serolugo/fpga-universal-expansion-board/images/picture01.jpeg

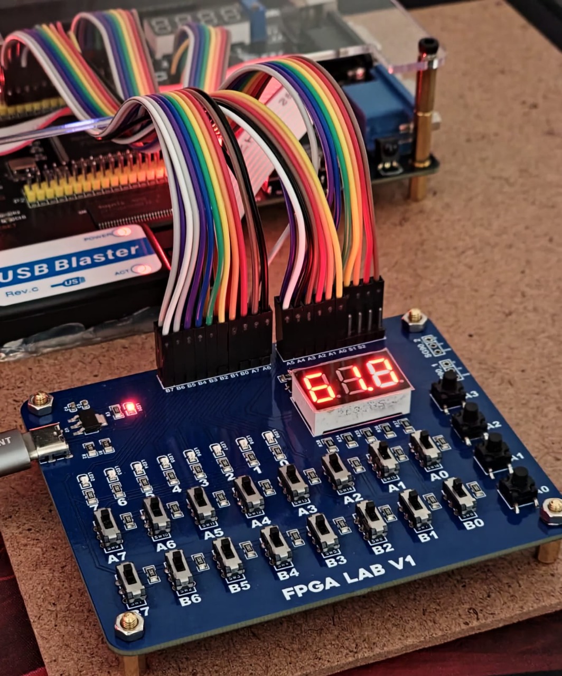
images/picture01.jpeg
