serolugo/fpga-universal-expansion-board/Rev.2/images/2d_pcb_front.png

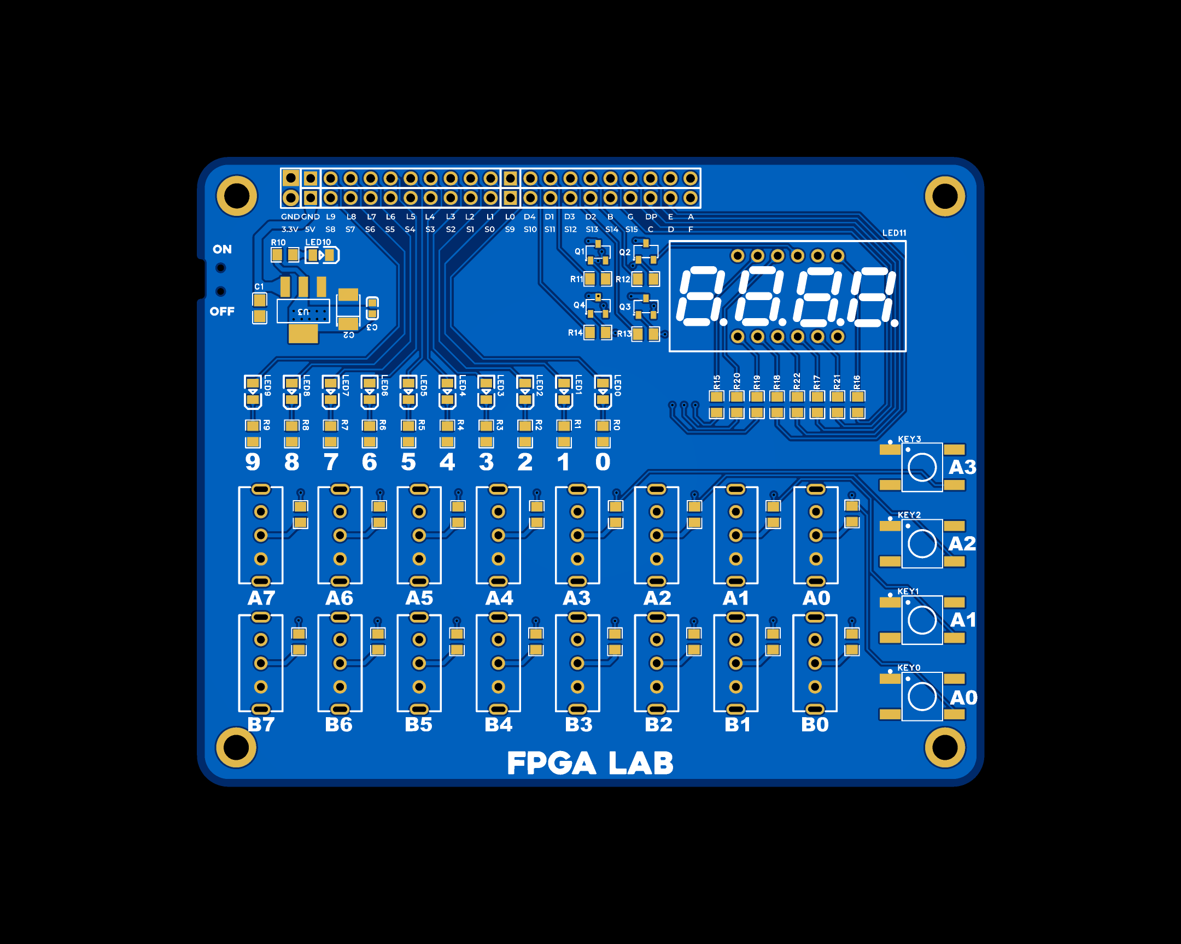
Rev.2/images/2d_pcb_front.png
