serolugo/fpga-universal-expansion-board/Rev.2/images/3d_pcb_back.png

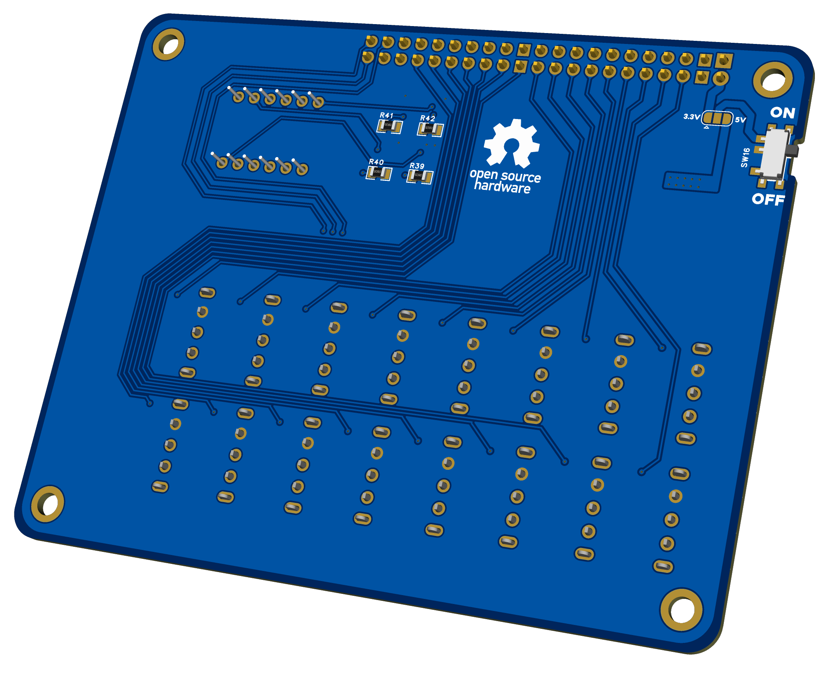
Rev.2/images/3d_pcb_back.png
