serolugo/fpga-universal-expansion-board/Rev.2/Schematic/SCH_Schematic1_2026-01-11.jpg

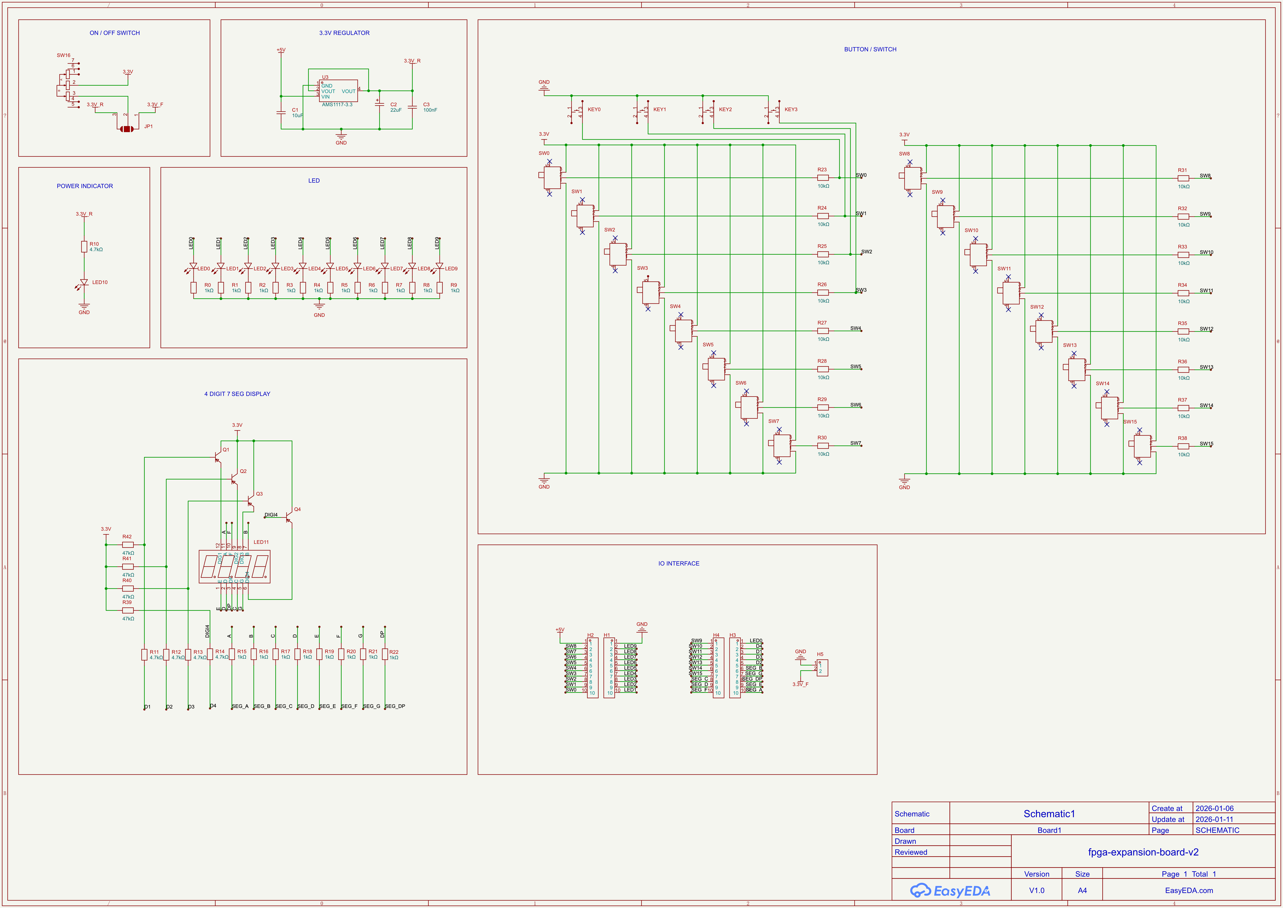
Rev.2/Schematic/SCH_Schematic1_2026-01-11.jpg
