serolugo/fpga-universal-expansion-board/Rev.2/bom/BOM_Board1_PCB1_2026-01-11.csv

No. | Quantity | Comment | Designator | Footprint | Value | Manufacturer Part | Manufacturer | Supplier Part | Supplier
1 | 1 | 10uF | C1 | C0805 | 10uF | GRM21BR61H106KE43L | muRata(村田) | C440198 | LCSC
2 | 1 | 22uF | C2 | CASE-B_3528 | 22uF | TAJB226K016RNJ | Kyocera AVX | C8020 | LCSC
3 | 1 | 100nF | C3 | C0603 | 100nF | CC0603KRX7R9BB104 | YAGEO(国巨) | C14663 | LCSC
4 | 4 | 5AML4-11560-110-W0 | H1,H2,H3,H4 | HDR-TH_10P-P2.54-V-M-1 |  | 5AML4-11560-110-W0 | SAMZO(三佐) | C41374240 | LCSC
5 | 1 | FG-PZ2.54-01-02P | H5 | HDR-TH_2P-P2.54-V-M |  | FG-PZ2.54-01-02P | FG(富港) | C42391436 | LCSC
6 | 1 | Jumper:SolderJumper-3_P1.3mm_Open_RoundedPad1.0x1.5mm | JP1 | Jumper:SolderJumper-3_P1.3mm_Open_RoundedPad1.0x1.5mm
7 | 4 | KH-6X6X6H-SMT-FS-D | KEY0,KEY1,KEY2,KEY3 | SW-SMD_4P-L6.0-W6.0-P4.50-LS9.5 |  | KH-6X6X6H-SMT-FS-D | kinghelm(金航标) | C18186510 | LCSC
8 | 11 | NCD0805R1 | LED0,LED1,LED2,LED3,LED4,LED5,LED6,LED7,LED8,LED9,LED10 | LED0805-R-RD |  | NCD0805R1 | 国星光电 | C84256 | LCSC
9 | 1 | SR410361N | LED11 | LED-SEG-TH_12P-L30.0-W14.0-P2.54-S10.26-BL |  | SR410361N | ARKLED(方舟) | C132660 | LCSC
10 | 4 | SS8550 | Q1,Q2,Q3,Q4 | SOT-23-3_L2.9-W1.4-P1.90-LS2.6-BR |  | SS8550 | TWGMC(迪嘉) | C727138 | LCSC
11 | 18 | 1kΩ | R0,R1,R2,R3,R4,R5,R6,R7,R8,R9,R15,R16,R17,R18,R19,R20,R21,R22 | R0805 | 1kΩ | 0805W8F1001T5E | UNI-ROYAL(厚声) | C17513 | LCSC
12 | 5 | 4.7kΩ | R10,R11,R12,R13,R14 | R0805 | 4.7kΩ | 0805W8F4701T5E | UNI-ROYAL(厚声) | C17673 | LCSC
13 | 16 | 10kΩ | R23,R24,R25,R26,R27,R28,R29,R30,R31,R32,R33,R34,R35,R36,R37,R38 | R0805 | 10kΩ | 0805W8F1002T5E | UNI-ROYAL(厚声) | C17414 | LCSC
14 | 4 | 47kΩ | R39,R40,R41,R42 | R0805 | 47kΩ | 0805W8F4701T5E | UNI-ROYAL(厚声) |  | LCSC
15 | 16 | SS12F44G4 | SW0,SW1,SW2,SW3,SW4,SW5,SW6,SW7,SW8,SW9,SW10,SW11,SW12,SW13,SW14,SW15 | SW-TH_SHOU-HAN_SS12F44G4 |  | SS12F44G4 | SHOU HAN(首韩) | C2887261 | LCSC
16 | 1 | MK-12C02-G015 | SW16 | SW-SMD_G-SWITCH_MK-12C02-G015 |  | MK-12C02-G015 | G-Switch(品赞) | C2911519 | LCSC
17 | 1 | AMS1117-3.3 | U3 | SOT-223-3_L6.5-W3.4-P2.30-LS7.0-BR |  | AMS1117-3.3 | AMS | C6186 | LCSC
