serolugo/fpga-universal-expansion-board/Rev.2/Schematic/SCH_Schematic1_2026-01-11.pdf

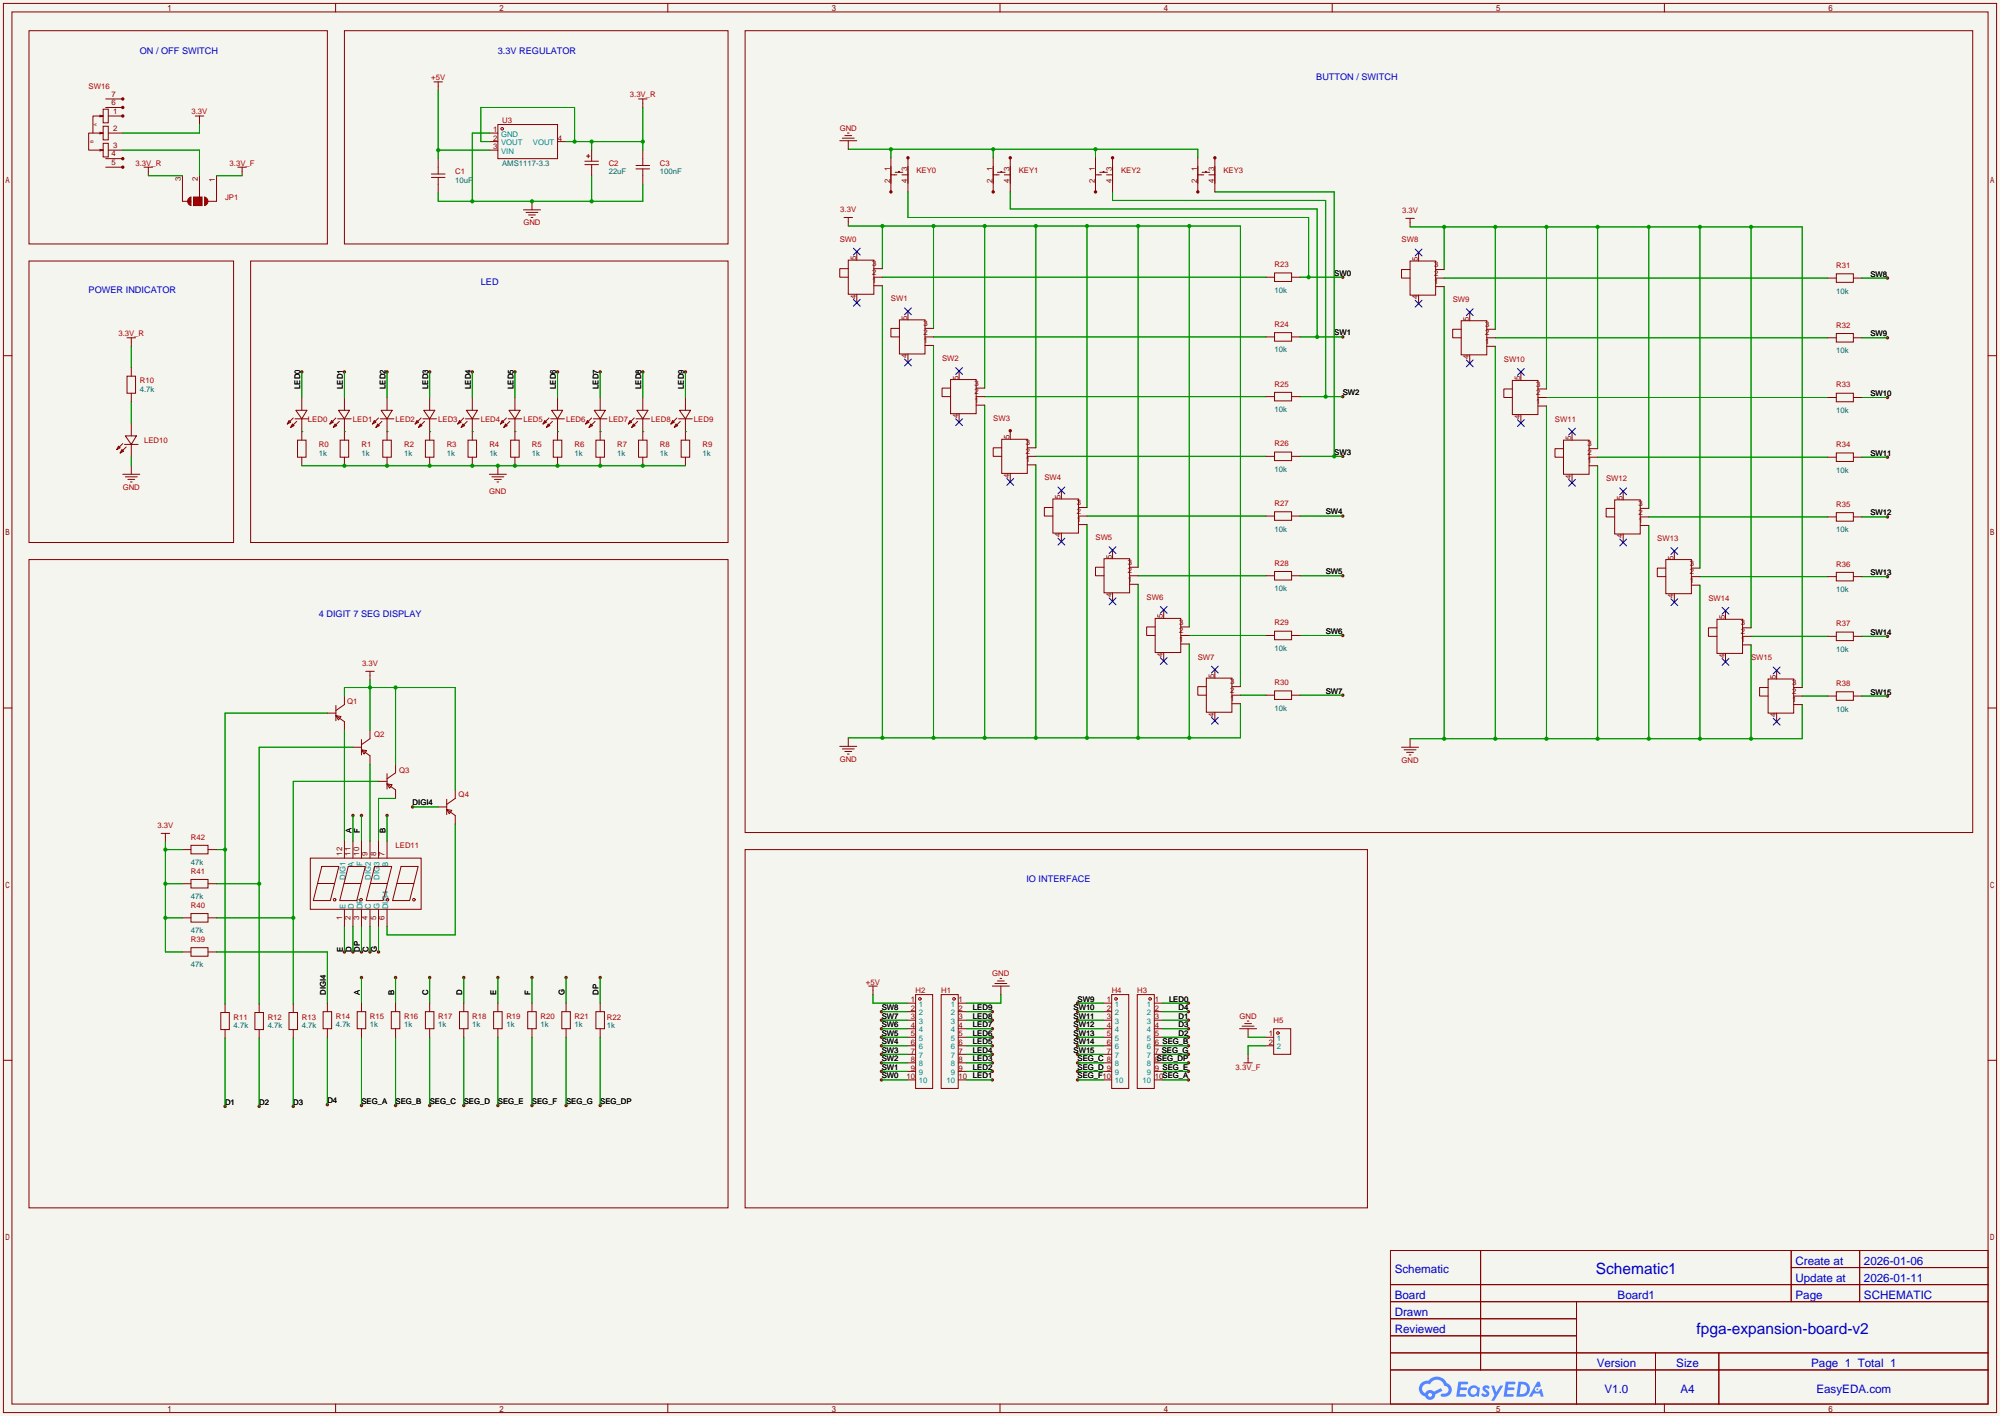
[picture p9: page 1]

Schematic | Schematic1 | Create at | 2026-01-06

Update at | 2026-01-11

Board | Board1 | Page | SCHEMATIC
Drawn | | fpga-expansion-board-v2
Reviewed

Version | Size | Page 1 Total 1
V1.0 | A4 | EasyEDA.com
