serolugo/fpga-universal-expansion-board/Rev.1/Schematic/SCH_Schematic1_2026-01-11.pdf

# Alimentación

# Regulación

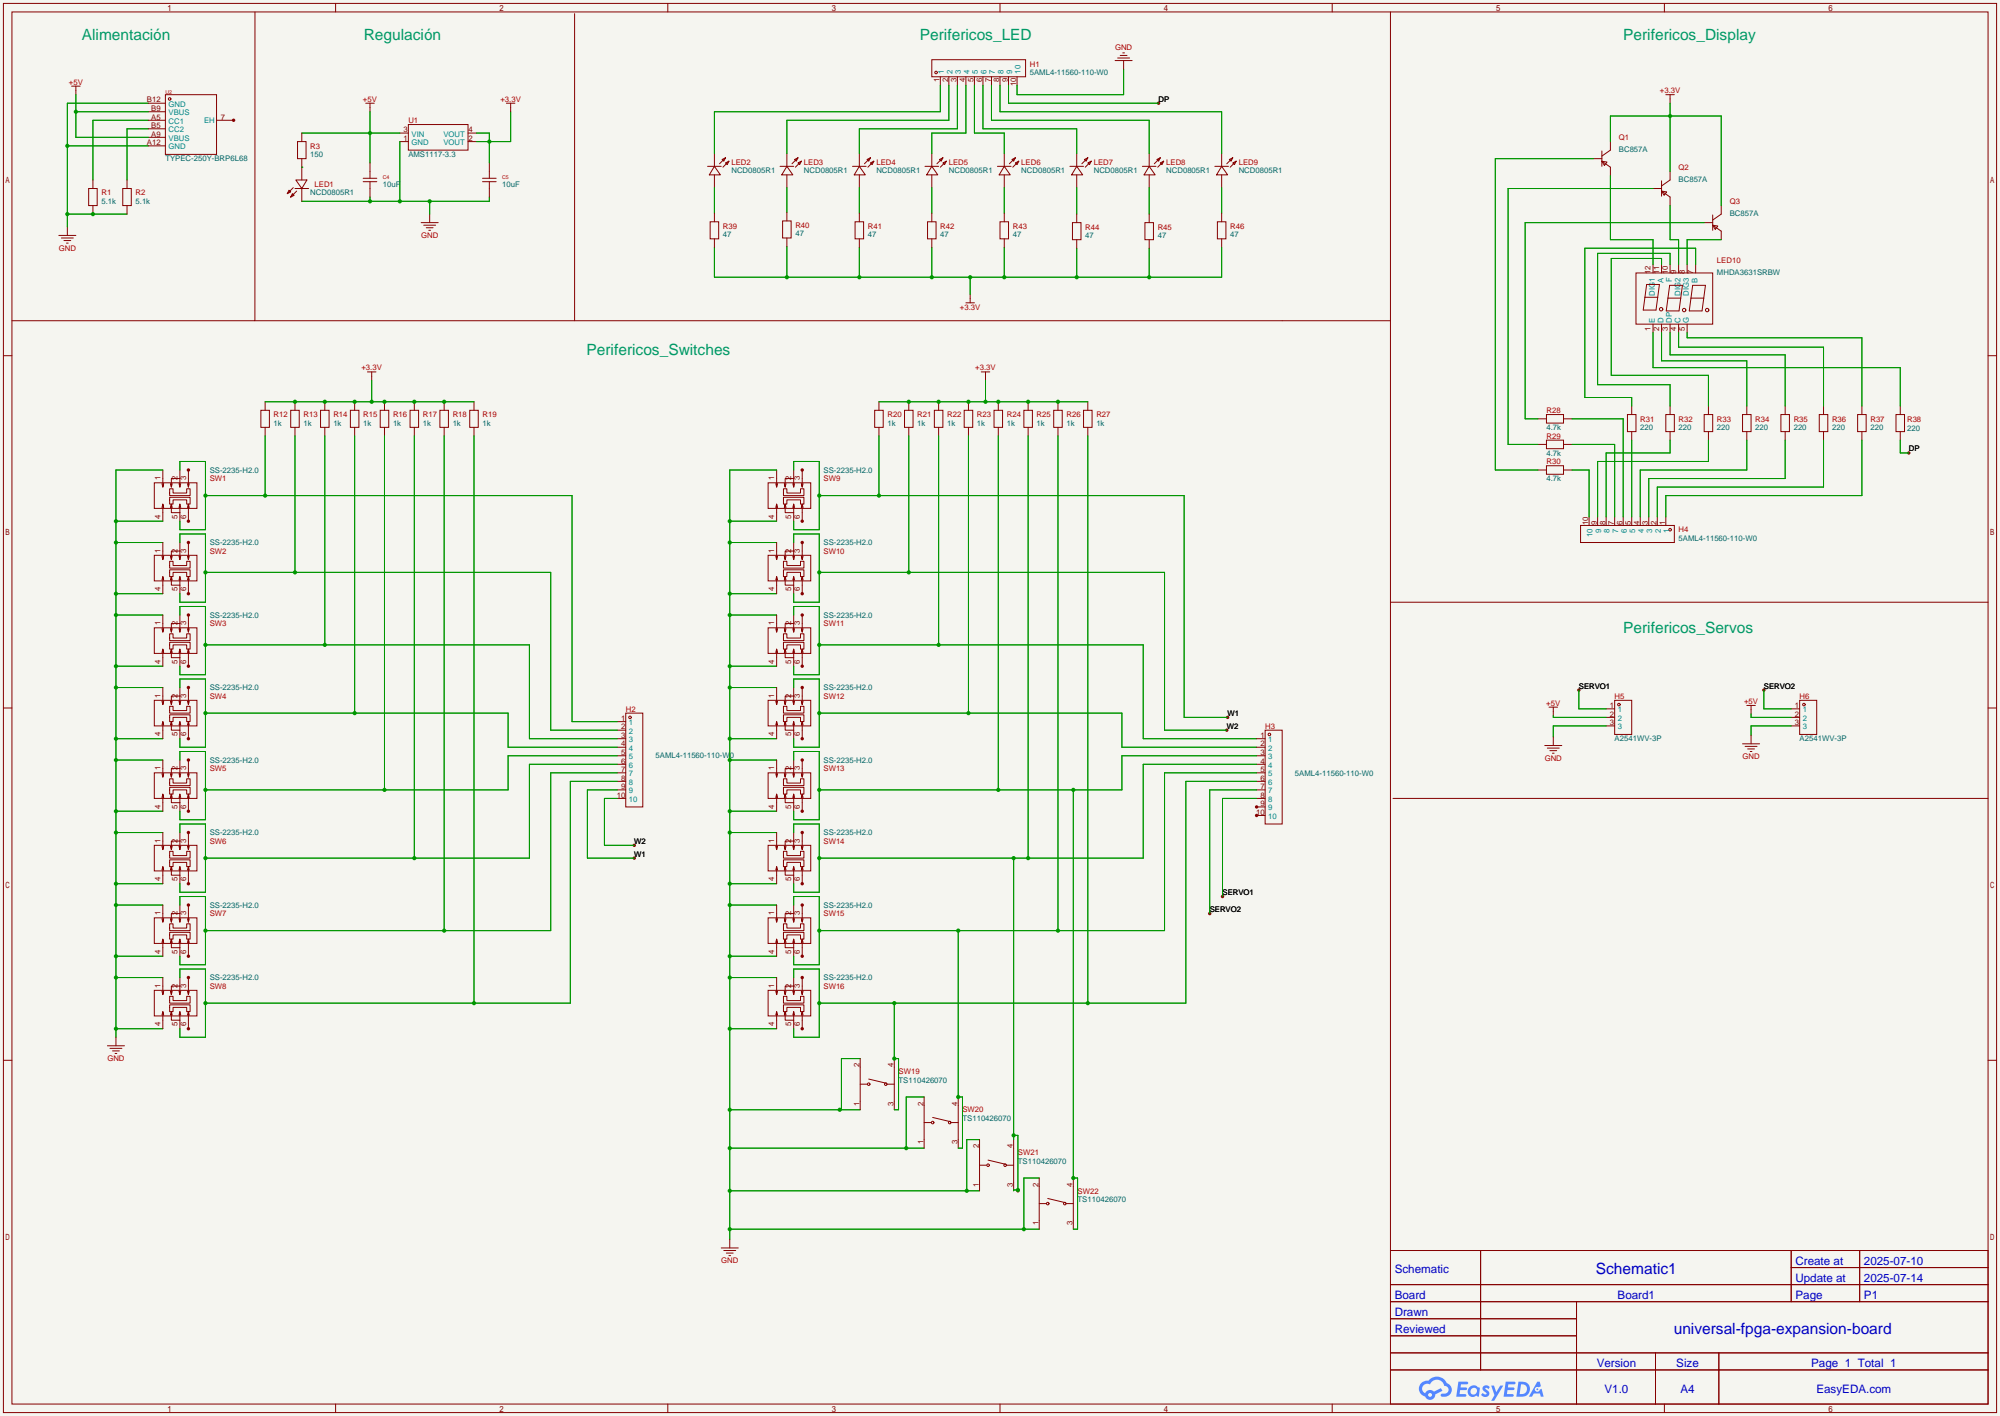
[picture p10: page 1]

Schematic | Schematic1 | Create at | 2025-07-10

Update at | 2025-07-14

Board | Board1 | Page | P1
Drawn | | universal-fpga-expansion-board
Reviewed

Version | Size | Page 1 Total 1
V1.0 | A4 | EasyEDA.com
