serolugo/fpga-universal-expansion-board/(list of files, drawings)

Other design files:
Rev.1/pcb/ProPrj_universal-fpga-expansion-board_2026-01-11.epro
Rev.2/pcb/ProPrj_fpga-expansion-board-v2_2026-01-11.epro
